CharlestonRobotics/ChIMP/(commit log)

2022-02-27 Update setup script for compatibilty with latest odrive version.
2022-02-27 Make odrive setup script executable.
2022-03-05 Add pos and vel controller params to odrive setup script.
2022-03-06 Add generic interrupt callback and specific wrappers.
2022-03-14 Add interactive motor test sketch.
2022-03-14 Do not arm motors on startup.
2022-03-16 Improve motor test.
    Add all other tests to ChIMP.ino.
2022-03-18 Add error detection to odrive setup script.
    [odrive_setup.py]
2022-03-18 Add motor and system error decoding to setup script.
    [odrive_setup.py]
2022-03-18 Slight tweaks to unknow error handling printout.
    [odrive_setup.py]
2022-03-19 Add Hall sensor test without ODRive.
2022-03-19 Use memcpy to copy hall state.
2022-03-19 Change hall state data type to uint8_t.
2022-03-20 Add command current limit to ChIMP.ino
2022-03-20 Replace custom constrain with built-in Arduino constrain.
    [ChIMP.ino]
2022-03-25 Add to motor direction checks and instructions to test readme.
    Make the required code changes to ChIMP.ino.
2022-03-27 Add individual PWM offset parameters.
